Tropingenie/ECE-499/README.md

# ECE-499
[Nozzle Flow Control for Agricultural Integration](https://tropingenie.github.io/ECE-499-Website/)
