Tropingenie/ECE-499/Hardware/ece_499/Addons/ESP32-C3_SUPERMINI/ESP32-C3_supermini_v5.step

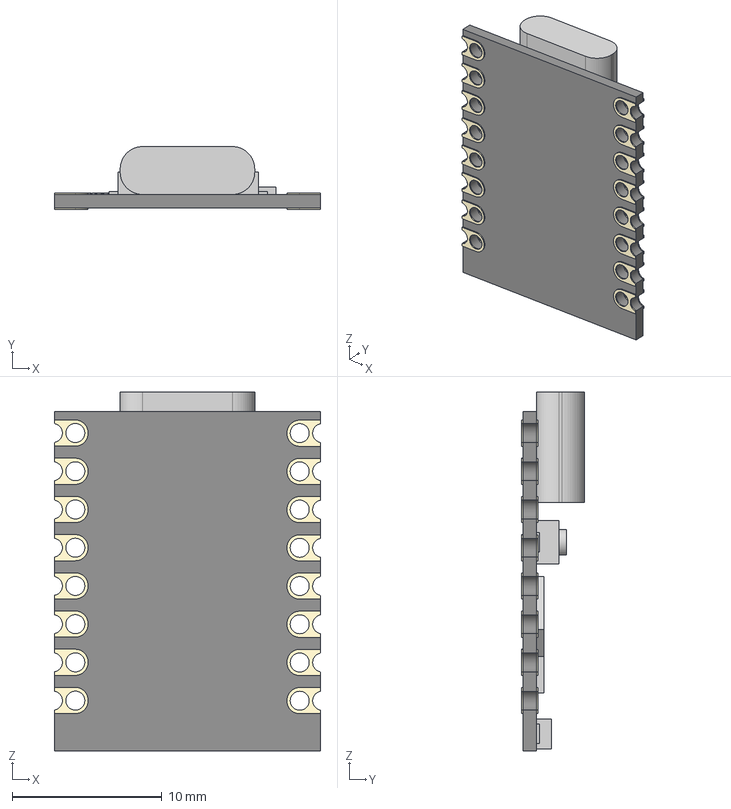
[picture p1: CAD file, 2024-05-21]
Hardware/ece_499/Addons/ESP32-C3_SUPERMINI/ESP32-C3_supermini_v5.step
17.8 x 4.20 x 24.0 mm
