Tropingenie/ECE-499/Hardware/Enclosure/Lid v2.stl

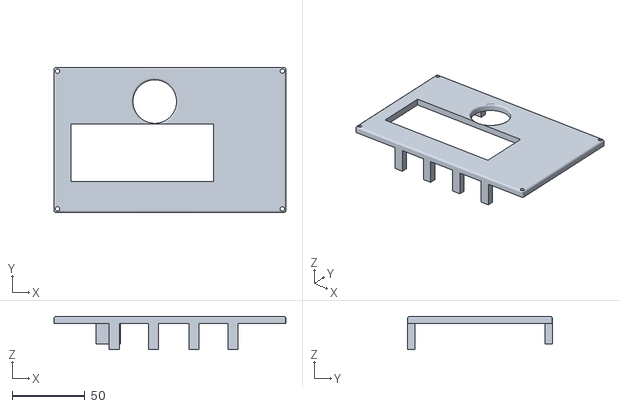
[picture p2: CAD file, 2024-07-27]
Hardware/Enclosure/Lid v2.stl
160.0 x 100.0 x 23.0
