Tropingenie/ECE-499/Hardware/Enclosure/Small_Enclosure.stl

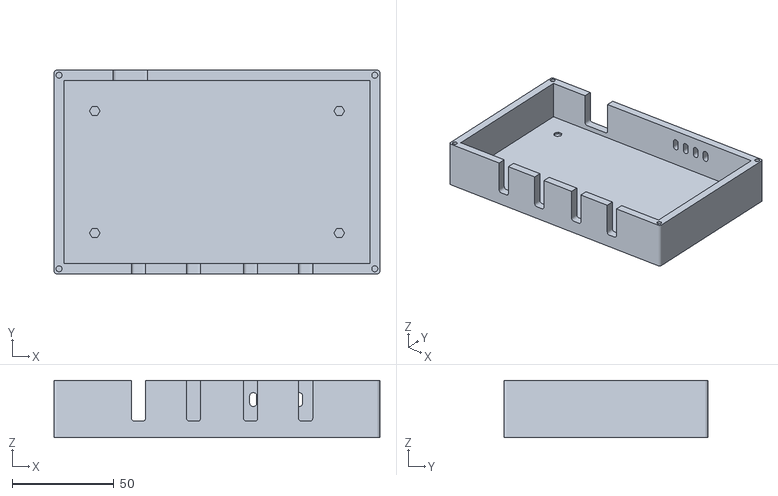
[picture p3: CAD file, 2024-07-27]
Hardware/Enclosure/Small_Enclosure.stl
160.0 x 100.0 x 28.0
