Tropingenie/ECE-499/Hardware/Enclosure/Small_Lid.stl

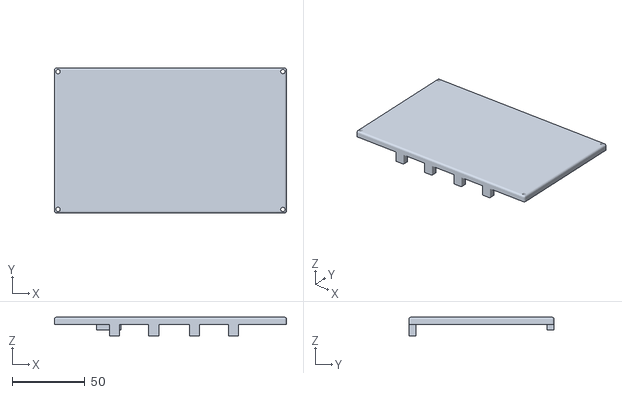
[picture p4: CAD file, 2024-07-27]
Hardware/Enclosure/Small_Lid.stl
160.0 x 100.0 x 13.0
