Tropingenie/ECE-499/Hardware/Enclosure/Enclosure.stl

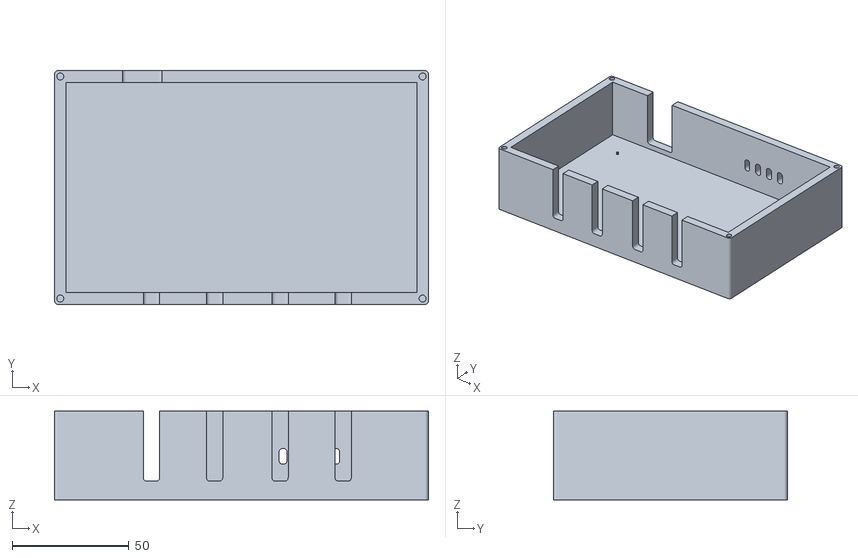
[picture p5: CAD file, 2024-07-19]
Hardware/Enclosure/Enclosure.stl
160.0 x 100.0 x 38.0
