Tropingenie/ECE-499/Hardware/Enclosure/Lid.stl

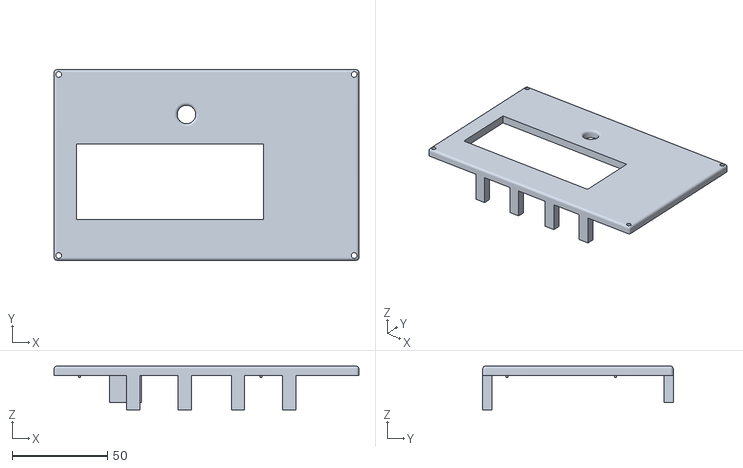
[picture p6: CAD file, 2024-07-19, an earlier design]
Hardware/Enclosure/Lid.stl
160.0 x 100.0 x 23.0
