Tropingenie/ECE-499/(list of files, cad)

Other CAD files:
Hardware/Enclosure/case v19.f3z
Hardware/Enclosure/small case v3.f3z
