Tropingenie/ECE-499/Hardware/ece_499/ece_499_cleanedup.pdf

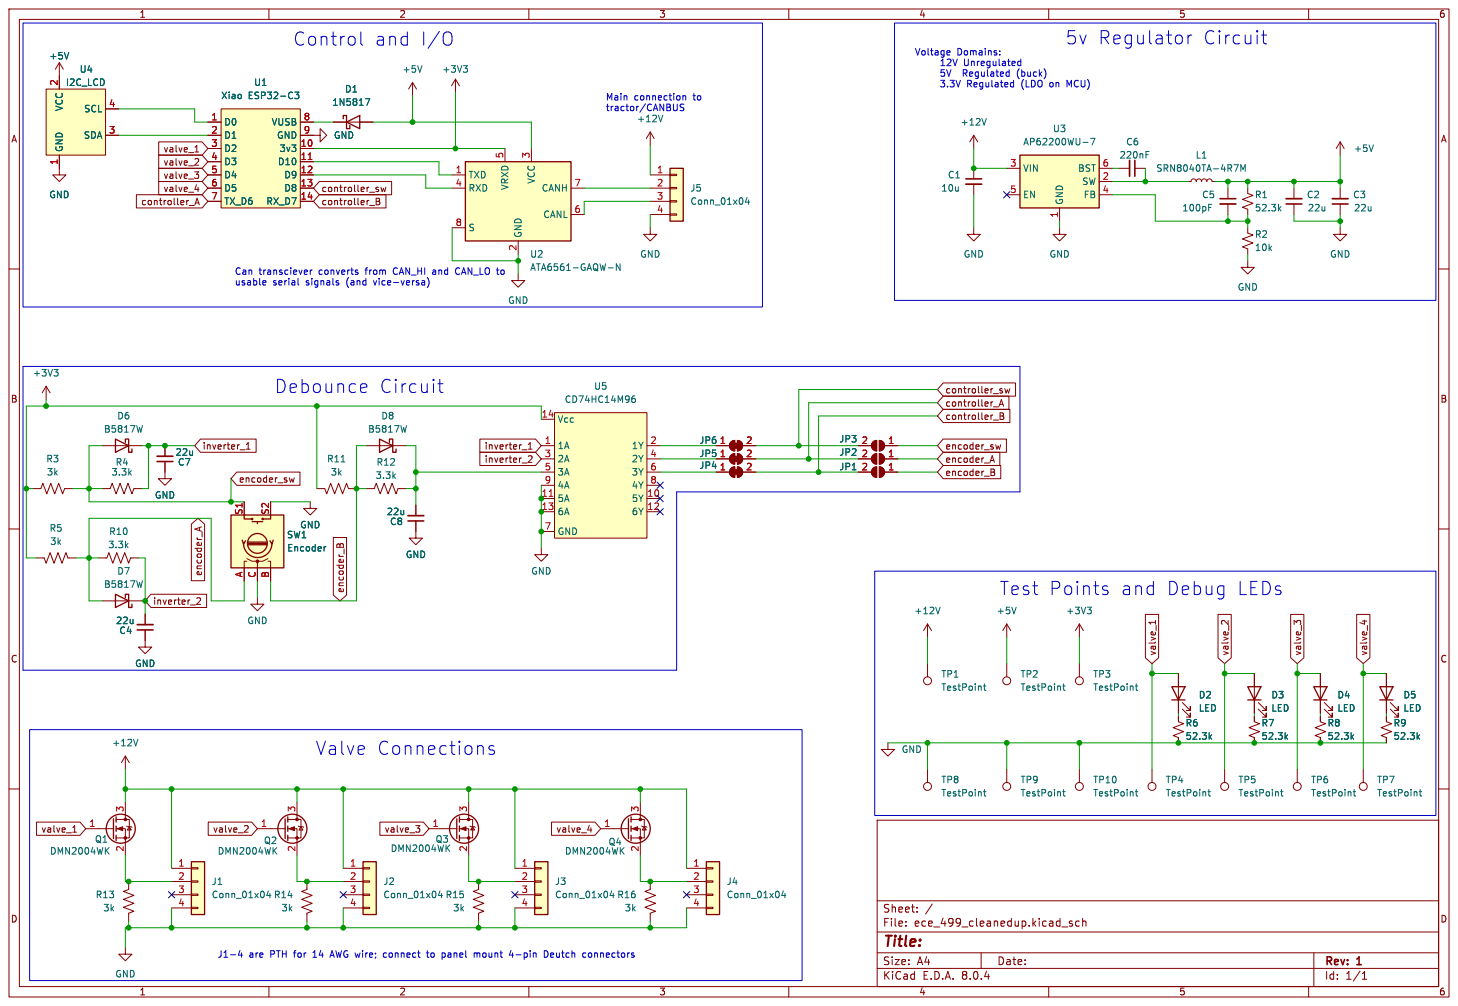
[picture p7: page 1]

1 SW 2 VIN 3 FB 4 EN 5 BST 6 U3 AP62200WU-7 C6

usable serial signals (and vice-versa)
