Tropingenie/ECE-499/Hardware/ece_499/ece_499.kicad_pcb

## KiCad design Hardware/ece_499/ece_499.kicad_pcb (2024-06-22)

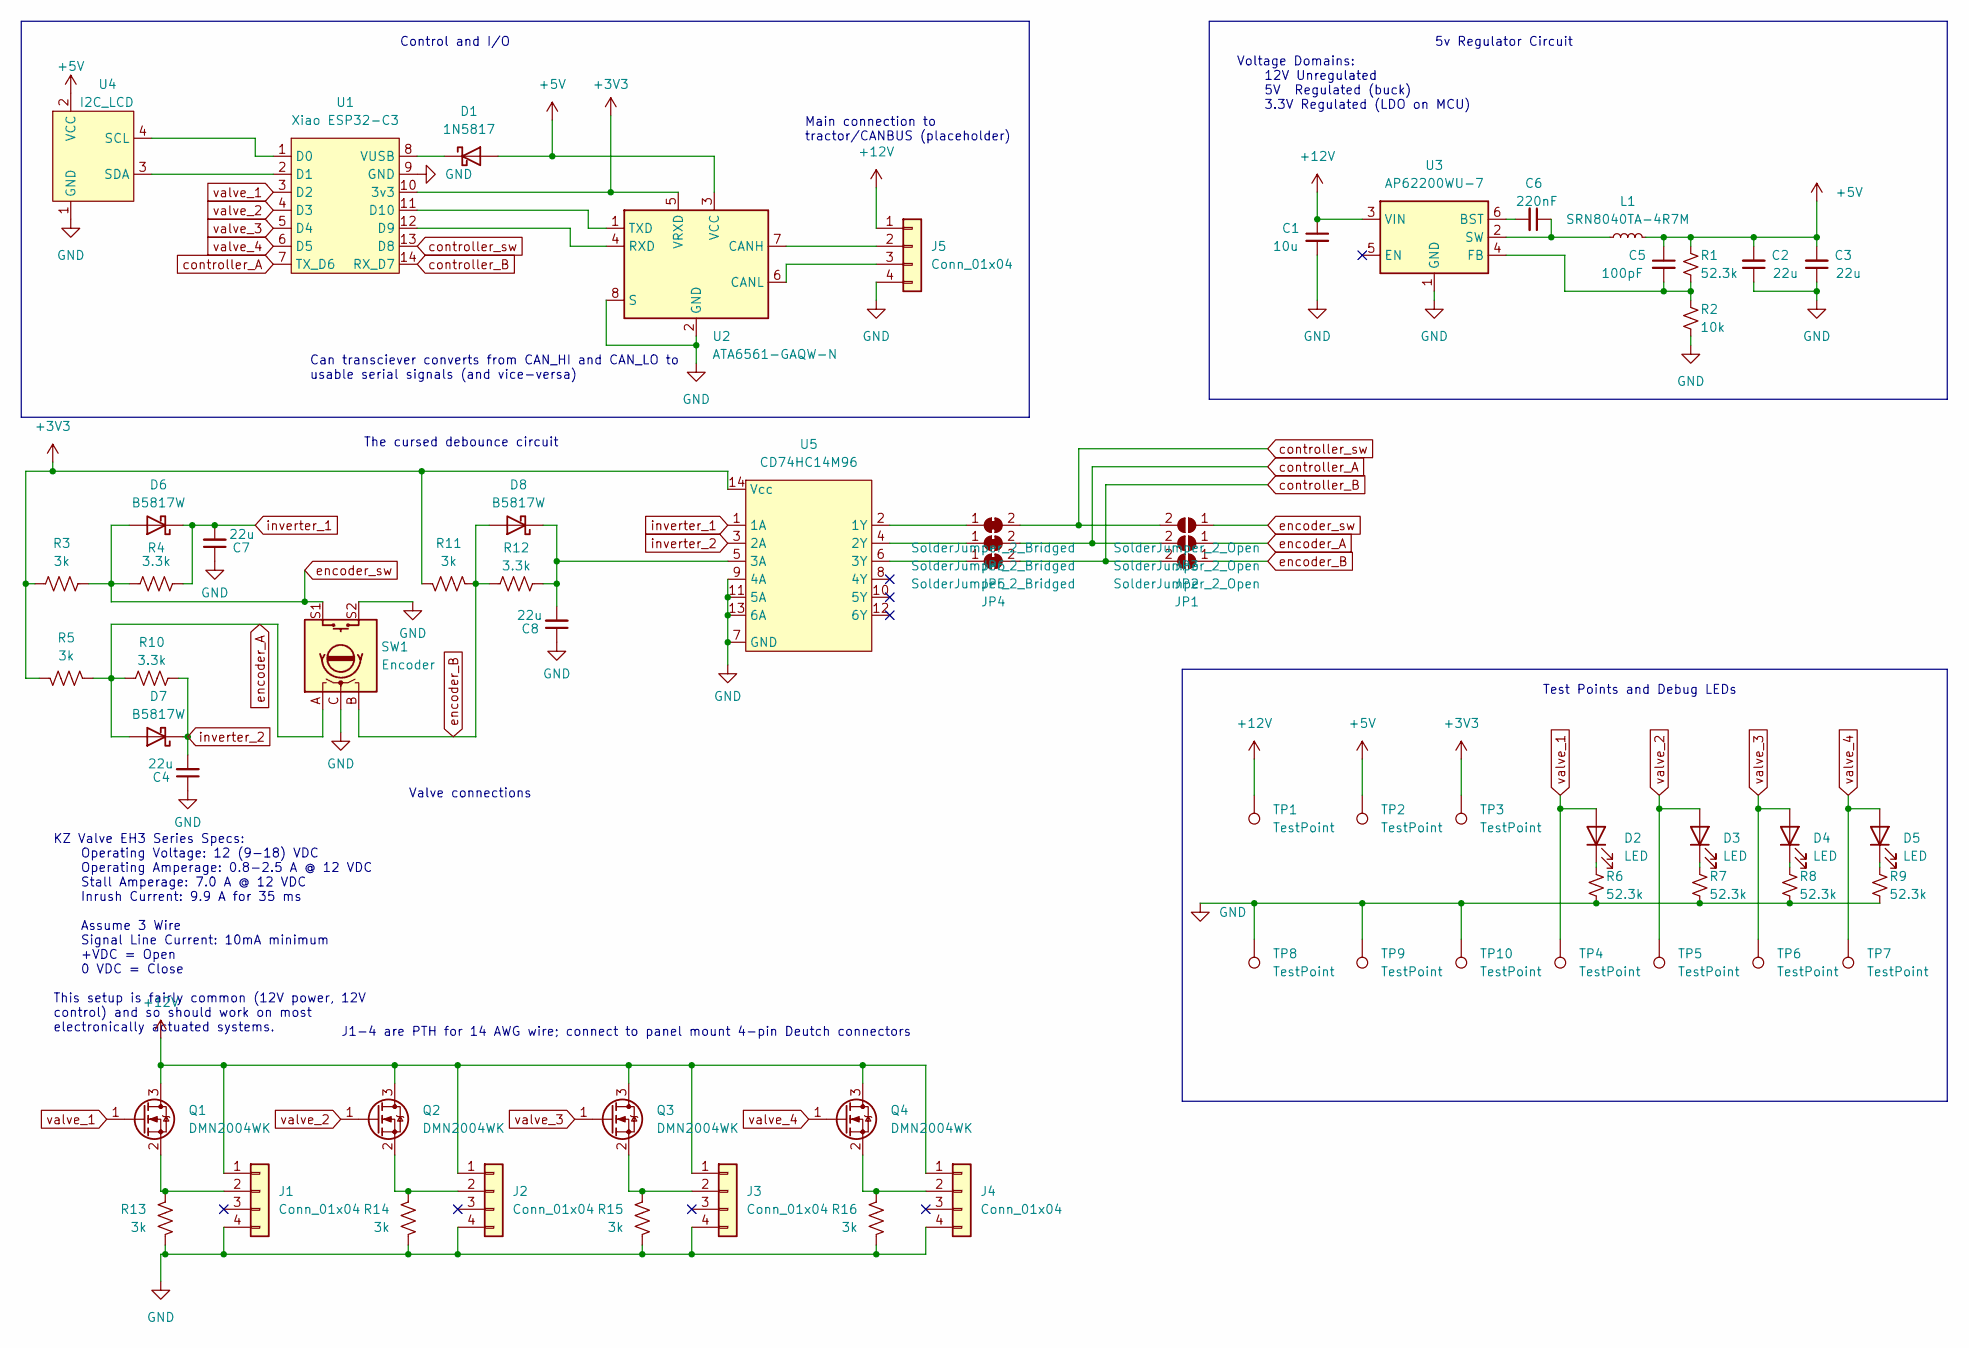
[picture p8: schematic ece_499.kicad_sch]

Parts:
C1: 10u; C_0805_2012Metric_Pad1.18x1.45mm_HandSolder
C2, C3, C4, C7, C8: 22u; C_0805_2012Metric_Pad1.18x1.45mm_HandSolder
C5: 100pF; C_0805_2012Metric_Pad1.18x1.45mm_HandSolder
C6: 220nF; C_0805_2012Metric_Pad1.18x1.45mm_HandSolder
D1: 1N5817; D_A-405_P7.62mm_Horizontal
D2, D3, D4, D5: LED; LED_D5.0mm
D6, D7, D8: B5817W; D_SOD-123
J1, J2, J3, J4, J5: Conn_01x04; 14 AWG 01x04
JP1, JP2, JP3: SolderJumper_2_Open; SolderJumper-2_P1.3mm_Open_RoundedPad1.0x1.5mm
JP4, JP5, JP6: SolderJumper_2_Bridged; SolderJumper-2_P1.3mm_Bridged2Bar_RoundedPad1.0x1.5mm
L1: SRN8040TA-4R7M; IND_SRN8040TA-4R7M
Q1, Q2, Q3, Q4: DMN2004WK; SOT-323_SC-70
R1: 52.3k; R_1206_3216Metric_Pad1.30x1.75mm_HandSolder
R2: 10k; R_1206_3216Metric_Pad1.30x1.75mm_HandSolder
R3, R5, R11, R13, R14, R15, R16: 3k; R_1206_3216Metric_Pad1.30x1.75mm_HandSolder
R4, R10, R12: 3.3k; R_1206_3216Metric_Pad1.30x1.75mm_HandSolder
R6, R7, R8, R9: 52.3k; R_Axial_DIN0204_L3.6mm_D1.6mm_P5.08mm_Horizontal
SW1: Encoder; PEC16-4015F-S0024
TP1, TP2, TP3, TP4, TP5, TP6, TP7, TP8, TP9, TP10: TestPoint; TestPoint_Pad_D2.0mm
U1: Xiao ESP32-C3; XIAO ESP32-C3
U2: ATA6561-GAQW-N; SOIC-8_3.9x4.9mm_P1.27mm
U3: AP62200WU-7; SOT-23-6_Handsoldering
U4: I2C_LCD; PinHeader_1x06_P1.00mm_Horizontal
U5: CD74HC14M96; SO-14_3.9x8.65mm_P1.27mm

Connections:
+3V3: R3.1, R5.1, R11.1, TP3.1, U1.10 (3v3), U2.5 (VRXD), U5.14 (Vcc)
+5V: C2.2, C3.2, C5.1, D1.2 (A), L1.2, R1.1, TP2.1, U2.3 (VCC), U4.2 (VCC)
+12V: C1.1, J1.1, J2.1, J3.1, J4.1, J5.1, Q1.3 (D), Q2.3 (D), Q3.3 (D), Q4.3 (D), TP1.1, U3.3 (VIN)
GND: C1.2, C2.1, C3.1, C4.1, C7.1, C8.1, J1.4, J2.4, J3.4, J4.4, J5.4, R2.2, R6.2, R7.2, R8.2, R9.2, R13.1, R14.1, R15.1, R16.1, SW1.C, SW1.S2, TP8.1, TP9.1, TP10.1, U1.9 (GND), U2.2 (GND), U2.8 (S), U3.1 (GND), U4.1 (GND), U5.7 (GND), U5.9 (4A), U5.11 (5A), U5.13 (6A)
unnamed: D1.1 (K), U1.8 (VUSB)
unnamed: D2.1 (K), R6.1
unnamed: D3.1 (K), R7.1
unnamed: D4.1 (K), R8.1
unnamed: D5.1 (K), R9.1
unnamed: C8.2, D8.1 (K), R12.1, U5.5 (3A)
unnamed: J1.2, Q1.2 (S), R13.2
unnamed: J2.2, Q2.2 (S), R14.2
unnamed: J3.2, Q3.2 (S), R15.2
unnamed: J4.2, Q4.2 (S), R16.2
unnamed: J5.2, U2.7 (CANH)
unnamed: J5.3, U2.6 (CANL)
unnamed: JP4.1 (A), U5.6 (3Y)
unnamed: JP5.1 (A), U5.4 (2Y)
unnamed: JP6.1 (A), U5.2 (1Y)
unnamed: U1.1 (D0), U4.4 (SCL)
unnamed: U1.2 (D1), U4.3 (SDA)
unnamed: U1.12 (D9), U2.4 (RXD)
unnamed: U1.11 (D10), U2.1 (TXD)
unnamed: C6.2, U3.6 (BST)
unnamed: C5.2, R1.2, R2.1, U3.4 (FB)
unnamed: C6.1, L1.1, U3.2 (SW)
controller_A: JP2.2 (B), JP5.2 (B), U1.7 (TX_D6)
controller_B: JP1.2 (B), JP4.2 (B), U1.14 (RX_D7)
controller_sw: JP3.2 (B), JP6.2 (B), U1.13 (D8)
encoder_A: D7.2 (A), JP2.1 (A), R5.2, R10.2, SW1.A
encoder_B: D8.2 (A), JP1.1 (A), R11.2, R12.2, SW1.B
encoder_sw: D6.2 (A), JP3.1 (A), R3.2, R4.2, SW1.S1
inverter_1: C7.2, D6.1 (K), R4.1, U5.1 (1A)
inverter_2: C4.2, D7.1 (K), R10.1, U5.3 (2A)
valve_1: D2.2 (A), Q1.1 (G), TP4.1, U1.3 (D2)
valve_2: D3.2 (A), Q2.1 (G), TP5.1, U1.4 (D3)
valve_3: D4.2 (A), Q3.1 (G), TP6.1, U1.5 (D4)
valve_4: D5.2 (A), Q4.1 (G), TP7.1, U1.6 (D5)

Notes on the sheet:
Valve connections
5v Regulator Circuit
KZ Valve EH3 Series Specs: Operating Voltage: 12 (9-18) VDC Operating Amperage: 0.8-2.5 A @ 12 VDC Stall Amperage: 7.0 A @ 12 VDC Inrush Current: 9.9 A for 35 ms Assume 3 Wire Signal Line Current: 10mA minimum +VDC = Open 0 VDC = Close This setup is fairly common (12V power, 12V control) and so sho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
Control and I/O
Voltage Domains: 12V Unregulated 5V Regulated (buck) 3.3V Regulated (LDO on MCU)
The cursed debounce circuit
Can transciever converts from CAN_HI and CAN_LO to usable serial signals (and vice-versa)
Main connection to tractor/CANBUS (placeholder)
J1-4 are PTH for 14 AWG wire; connect to panel mount 4-pin Deutch connectors
Test Points and Debug LEDs

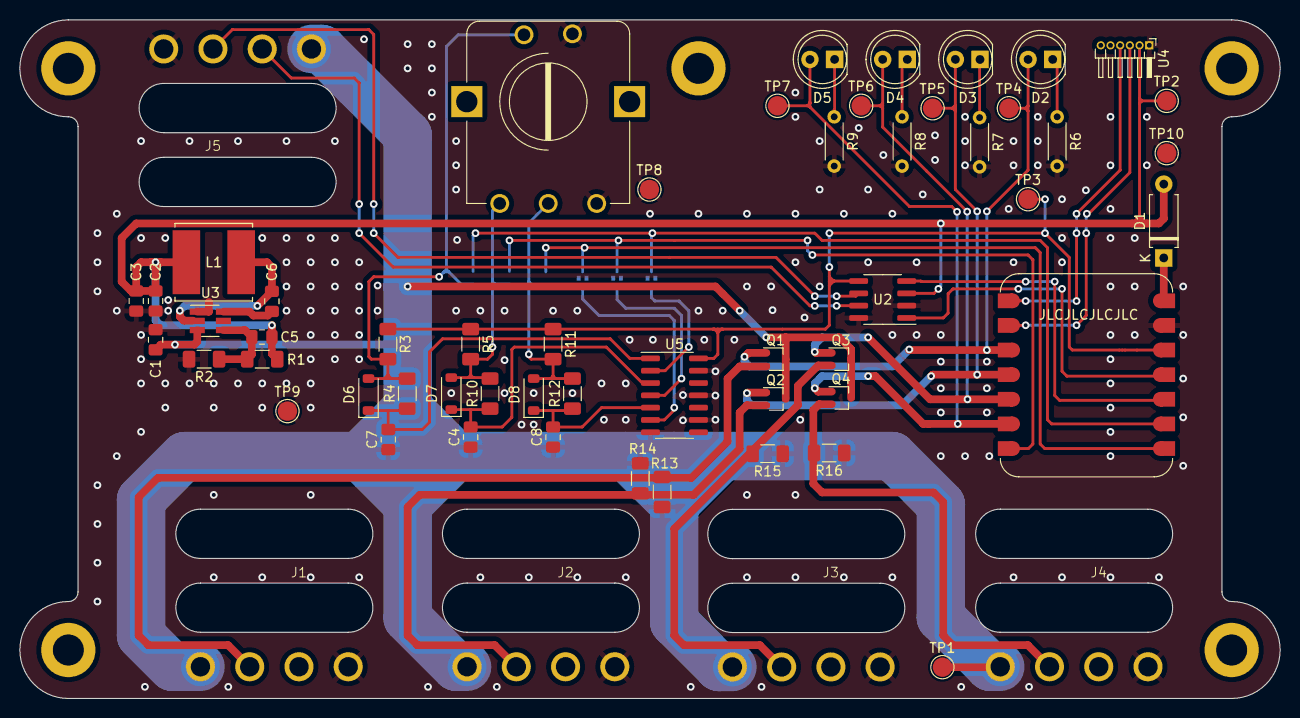
[picture p9: board ece_499.kicad_pcb from above]

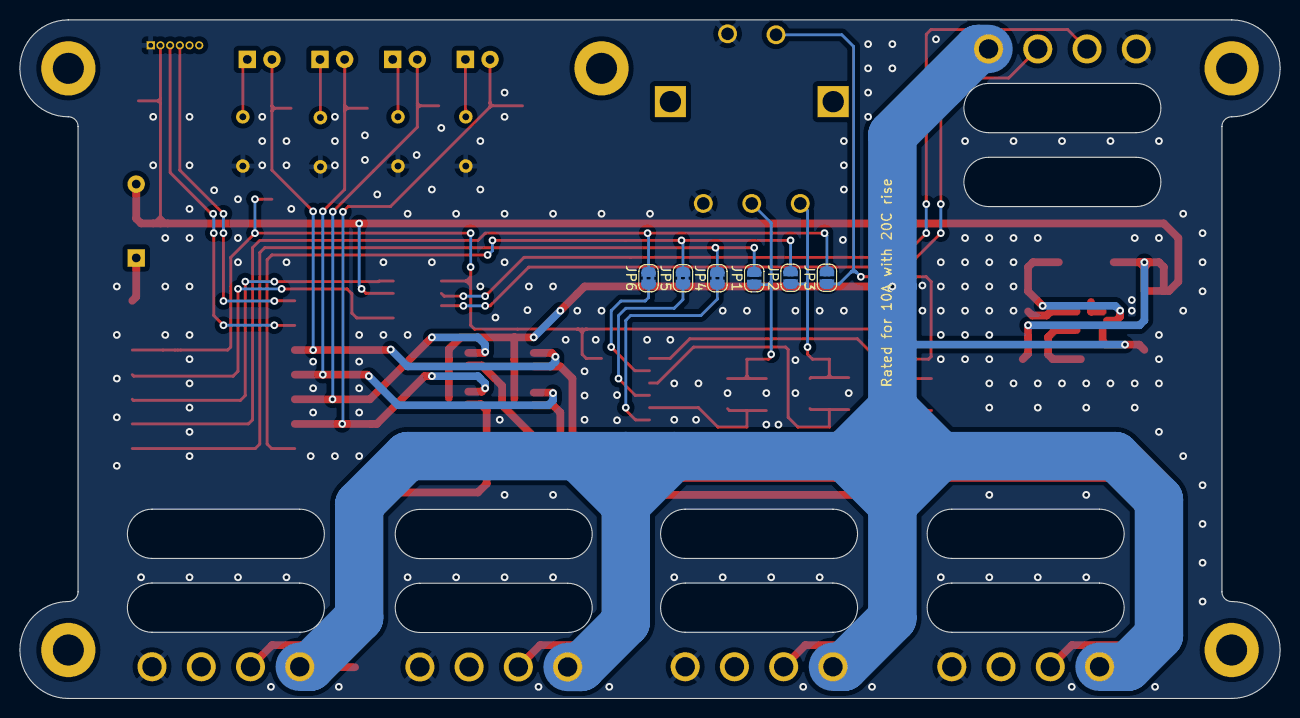
[picture p10: board ece_499.kicad_pcb from below]

Board: 2 copper layers, 130.0 x 70.0 mm, 64 parts (6 on the bottom side), 38 nets.
