Tropingenie/ECE-499/(commit log)

2024-05-21 Initial hardware design considerations
    [ESP32-C3_supermini_v5.step, ece_499.kicad_pcb, ece_499.kicad_sch]
2024-05-23 Continue components selection and setup
    [ece_499.kicad_sch]
2024-05-24 Added parts
    -Created circuit for regulator
    -Wired up CAN transceiver
    -Added rotary encoder
    -Added I2C LCD interface
    [ece_499.kicad_sch]
2024-05-25 stop being dumb
    -fixed 5v into switch and can transceiver
    -made the symbol less bad for the i2c
    [ece_499.kicad_sch]
2024-05-28 Design connectors for connectors to actuators
    [ece_499.kicad_sch]
2024-05-28 Add more test points
    [ece_499.kicad_sch]
2024-05-30 Add debug LEDs to signal TPs
    [ece_499.kicad_sch]
2024-05-30 Complete footprint selection
    [ece_499.kicad_sch]
2024-05-30 Remove incorrect encoder footprint; add main CANBUS header
    [ece_499.kicad_sch]
2024-06-03 Set up PEC16 footprint
    [ece_499.kicad_sch]
2024-06-03 Validate footprints(corrected B5817W)
    [ece_499.kicad_sch]
2024-06-03 Initial PCB setup part 1
    [ece_499.kicad_pcb]
2024-06-03 Initial PCB layout and fix reg schema
    [ece_499.kicad_pcb, ece_499.kicad_sch]
2024-06-05 Cursed debouncy :(
    [ece_499.kicad_sch]
2024-06-06 Fix (?) debounce schema
    [ece_499.kicad_sch]
2024-06-09 Add new encoder design to initial PCB layout
    [ece_499.kicad_pcb, ece_499.kicad_sch]
2024-06-09 5v reg circuit on PCB
    [ece_499.kicad_pcb]
2024-06-09 Implement 3v3 lines on PCB
    [ece_499.kicad_pcb, ece_499.kicad_sch]
2024-06-09 Implement encoder debouncer
    [ece_499.kicad_pcb]
2024-06-09 Encoder and CAN receiver traces
    [ece_499.kicad_pcb]
2024-06-11 CANBUS tranceiver traces
    [ece_499.kicad_pcb]
2024-06-11 clean up encoder traces
    [ece_499.kicad_pcb]
2024-06-11 clean up 3v3 trace
    [ece_499.kicad_pcb]
2024-06-11 Initial valve FET connections
    [ece_499.kicad_pcb]
2024-06-11 More valve FET -> connector
    [ece_499.kicad_pcb]
2024-06-12 Add pulldowns on valve FETs
    [ece_499.kicad_sch]
2024-06-12 Add pulldowns to PCB
    [ece_499.kicad_pcb]
2024-06-12 Ground plane and start stitching vias
    [ece_499.kicad_pcb]
2024-06-12 More stitching vias
    [ece_499.kicad_pcb]
2024-06-12 Wire LCD header
    [ece_499.kicad_pcb]
2024-06-12 Run LED traces
    [ece_499.kicad_pcb]
2024-06-12 More vias, 3D model of PEC16
    [ece_499.kicad_pcb]
2024-06-12 fix resistor values, update datasheet
    -Fixed R1 values for debounce circuits
    -Changed all 2.7k resistors to 3k
    -Updated datasheet for DMN2004WK
    [ece_499.kicad_pcb, ece_499.kicad_sch]
2024-06-13 Moved testpoints
    -Moved the testpoints onto the board. All are on the front side of the board.
    -The zone boundaries are now an actual square.
    [ece_499.kicad_pcb]
2024-06-14 Minor fixes - Replace MCU diode with 1N5817 - Move 3v3 TP - Remove 90 degree traces - More stitching vias
    [ece_499.kicad_pcb, ece_499.kicad_sch]
2024-06-14 Export BOM for creating DigiKey order
    [BOM.csv]
2024-06-14 Run DRC - Validate footprints - Add thermal trace to reg - Move TP2 and TP10 to avoid overlapping silk - More stitching vias :)
    [ece_499.kicad_pcb]
2024-06-14 More vias, 3D models
    - More stitching vias
    - Add model for L1
    [ece_499.kicad_pcb]
2024-06-14 Touched kicad_pro file
2024-06-15 Mounting points - Add M3 mounting points - Clean up board edges - Validate manufacturing clearances
    [ece_499.kicad_pcb]
2024-06-15 Add dimensions to board file
    [ece_499.kicad_pcb]
2024-06-15 Add dimensions to board file part 2
    [ece_499.kicad_pcb]
2024-06-15 Add dimensions to board file part 3
    [ece_499.kicad_pcb]
2024-06-15 Hide SW1 silk
    [ece_499.kicad_pcb]
2024-06-15 Export Gerbers, update .gitignore
    [ece_499.kicad_pcb]
2024-06-22 Add SuperMini 3D model for screenshot
    [ece_499.kicad_pcb]
2024-07-19 Added enclosure design
    [Enclosure.stl, Lid.stl, case v16.f3z]
2024-07-27 additional enclosures
    [Lid v2.stl, Small_Enclosure.stl, Small_Lid.stl]
2024-07-27 added cleaned up version of schematic
    [ece_499_cleanedup.kicad_sch]
2024-07-28 Add arduino firmware as submodule
2024-07-28 Fix arduino firmware path
2024-07-28 Actually add arduino firmware with correct path
2024-08-05 Updated enclosure fusion exports
    [case v16.f3z, case v19.f3z, small case v3.f3z]
2024-08-11 Switch firmware submodules to main branch
